CodenameLiam/digital-voice-recorder/Simulation/Filter/Annotation 2019-05-26 104144.png

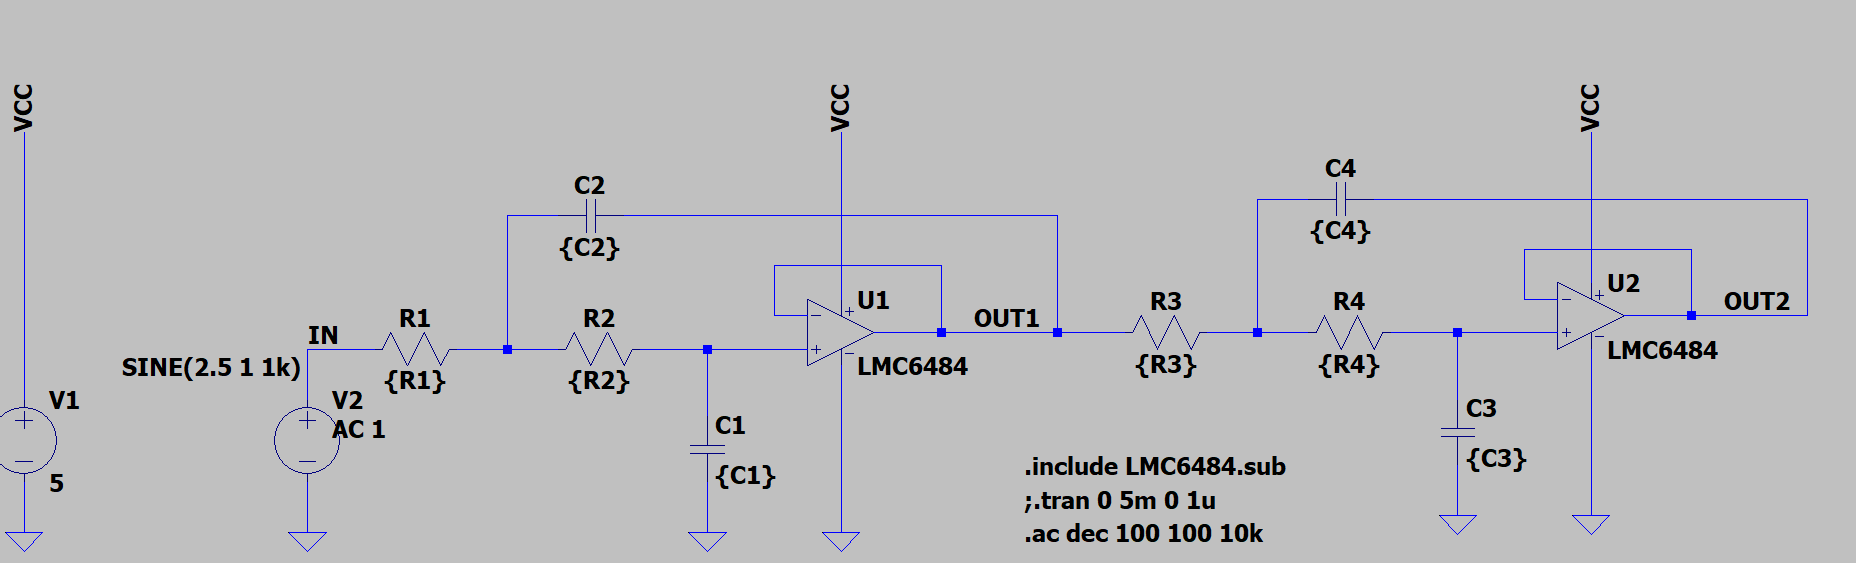
Simulation/Filter/Annotation 2019-05-26 104144.png
