CodenameLiam/digital-voice-recorder/Simulation/Filter/Filter Tuning.xlsx

Sheet: E Series
E12 | E24
1 | 1
1.2 | 1.1
1.5 | 1.2
1.8 | 1.3
2.2 | 1.5
2.7 | 1.6
3.3 | 1.8
3.9 | 2
4.7 | 2.2
5.6 | 2.4
6.8 | 2.7
8.2 | 3
10 | 3.3
 | 3.6
 | 3.9
 | 4.3
 | 4.7
 | 5.1
 | 5.6
 | 6.2
 | 6.8
 | 7.5
 | 8.2
 | 9.1
 | 10

Sheet: Filter Tuning C1&2
Q | 3.8842
C1 | 1 | nF
m | R ratio | n | C2
0 | 1.00 | 60.35 | 60.35
1 | 1.10 | 60.49 | 60.49 |  |  |  | n = (Q(1+m))^2/m
2 | 1.21 | 60.91 | 60.91
3 | 1.33 | 61.61 | 61.61
4 | 1.47 | 62.60 | 62.60
5 | 1.62 | 63.89 | 63.89
6 | 1.78 | 65.49 | 65.49
7 | 1.96 | 67.41 | 67.41
8 | 2.15 | 69.68 | 69.68
9 | 2.37 | 72.31 | 72.31
10 | 2.61 | 75.33 | 75.33
11 | 2.87 | 78.77 | 78.77
12 | 3.16 | 82.65 | 82.65
13 | 3.48 | 87.02 | 87.02
14 | 3.83 | 91.91 | 91.91
15 | 4.22 | 97.37 | 97.37
16 | 4.64 | 103.45 | 103.45
17 | 5.11 | 110.21 | 110.21
18 | 5.62 | 117.70 | 117.70
19 | 6.19 | 125.99 | 125.99
20 | 6.81 | 135.18 | 135.18
24 | 10.00 | 182.55 | 182.55
wn | 17136 | rad/s |  | C1 | 1 | nF
m | 1.96 |  |  | C2 | 68 | nF
R3 | 5054.847461 | Ohm
R4 | 9907.501023
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
