CodenameLiam/digital-voice-recorder/TeensyBOBv2.pdf

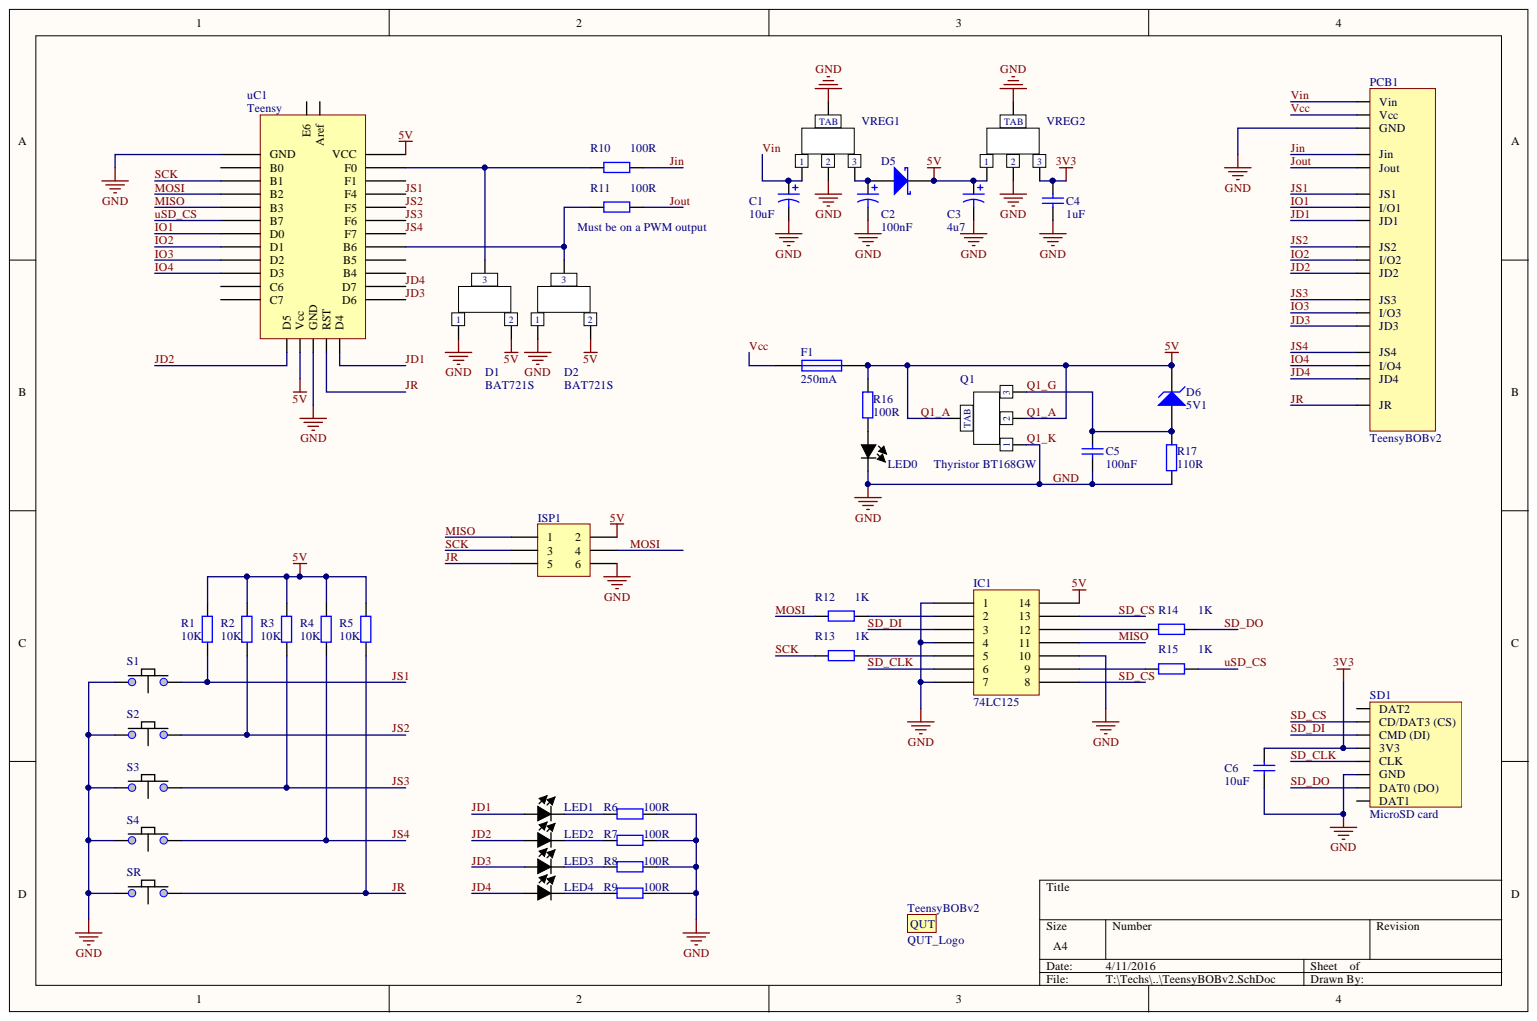
[picture p51: page 1]

Must be on a PWM output
