CodenameLiam/digital-voice-recorder/Simulation/Filter/LMC6484_Lowpass_Toleranced(1).asc

C1: cap; {C1}
C2: cap; {C2}
C3: cap; {C3}
C4: cap; {C4}
R1: res; {R1}
R2: res; {R2}
R3: res; {R3}
R4: res; {R4}
U1: opamp2; LMC6484
U2: opamp2; LMC6484
V1: voltage; 5
V2: voltage; SINE(2.5 1 1k); AC 1
Named nets: 0, OUT1, OUT2, IN, VCC
.include LMC6484.sub
;.tran 0 5m 0 1u
.ac dec 100 100 10k
.step param RUN 1 100 1
.meas AC Rp PP mag(V(OUT2)) TO 2780
.meas AC Amin PP mag(V(OUT2)) TO 7813
.param R3=mc(5.1k,0.01) R4=mc(10k,0.01) C3=mc(1n,0.05) C4=mc(68n,0.05)
.param R1=mc(8.2k,0.01) R2=mc(16k,0.01) C1=mc(5.6n,0.05) C2=mc(18n,0.05)
Anti-Alias Filter
Amplifiers are modelled to LMC6484 spec. w/ 5V supply.
Uses opamp2 symbol from Opamps library folder
Subcircuit placed on simulation  path
Simulation 1 - AC Analysis
Components are parameterised using potential tolerances
Potential values based on different tolerances are measured by simulating the circuit multiple times
