CodenameLiam/digital-voice-recorder/Simulation/Microphone/LMC6484.asc

C1: cap; 3.3µ
R1: res; 10k
R2: res; 1.2Meg
R4: res; 20k
R5: res; 20k
U1: opamp2; LMC6484
V1: voltage; 5
V2: voltage; SINE(3.2 20m 1k); AC 10m
Named nets: 0, OUT
.include LMC6484.sub
.tran 5m
Uses opamp2 symbol from Opamps library folder
;ac dec 200 0.1 100k
Microphone Bias and Amplification
Amplifiers are modelled to LMC6484 spec. w/ 5V supply.
Simulation 1 - DC Analysis
Simulation 2 - AC Analysis
Subcircuit placed on simulation  path
.probe V(OUT)
.probe V(OUT)
