CodenameLiam/digital-voice-recorder/Simulation/Resources/LMC6484.asc

R1: res; 10k
R2: res; 20k
R3: res; 500
U1: opamp2; LMC6484
V1: voltage; 5
V2: voltage; SINE(2.5 1 2k)
V3: voltage; 2.5
Named nets: 0, OUT
.include LMC6484.sub
.tran 5m
Uses "opamp2" symbol from "Opamps" library folder
