CodenameLiam/digital-voice-recorder/Simulation/Resources/SineModulatedPWM.asc

B1: bv; V=IF(V(Vmod)>V(Vtri),5,0)
C1: cap; 10n
R1: res; 10k
V1: voltage; SINE(2.5 2.5 1k)
V2: voltage; PULSE(0 5 0 16e-6 1n 0 16.001e-6)
Named nets: Vtri, Vmod, PWM, 0, Vout
.tran 0 1000u 0 1n
.ic V(Vout)=2.5
